IvannnHuang/TableRobot/cad/RobotWheel.stl

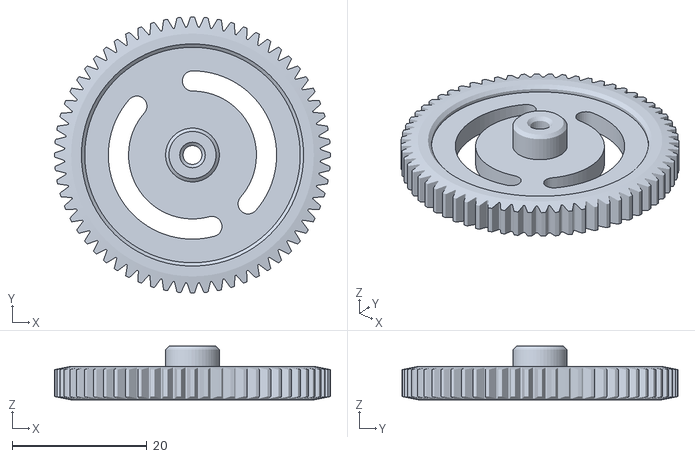
[picture p1: CAD file, 2026-10-29]
cad/RobotWheel.stl
41.0 x 41.0 x 8.00
