IvannnHuang/TableRobot/cad/RobotTOP.stl

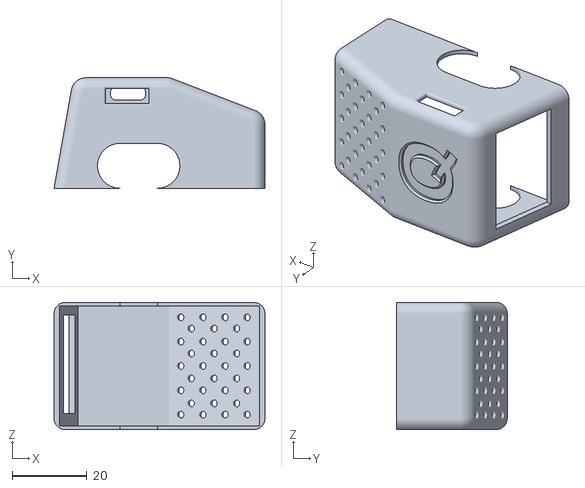
[picture p2: CAD file, 2026-10-27]
cad/RobotTOP.stl
56.4 x 29.5 x 34.0
