IvannnHuang/TableRobot/cad/RobotWheelConnector.stl

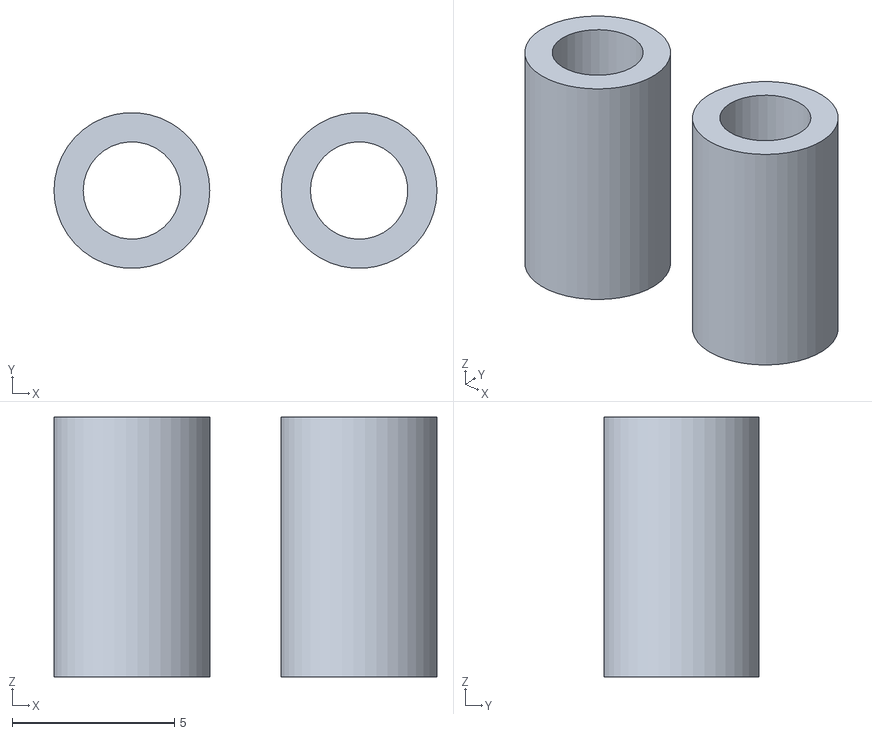
[picture p3: CAD file, 2026-10-27]
cad/RobotWheelConnector.stl
11.8 x 4.79 x 8.00
