IvannnHuang/TableRobot/cad/RobotBOTTOM.stl

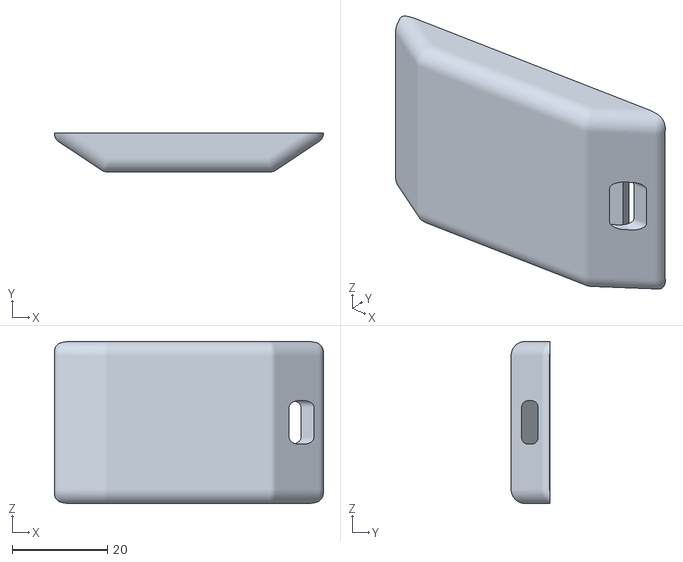
[picture p4: CAD file, 2026-10-27]
cad/RobotBOTTOM.stl
56.4 x 8.13 x 34.0
