IvannnHuang/TableRobot/(list of files, cad)

Other CAD files:
cad/RobotWheel.gcode.3mf
cad/qh229_RobotWheelConnector.gcode.3mf
