IvannnHuang/TableRobot/(commit log)

2026-10-27 tableRobot milestone
    [RobotBOTTOM.stl, RobotTOP.stl, RobotWheelConnector.stl, qh229_RobotWheelConnector.gcode.3mf]
2026-10-28 esp32c3 robot in progress
    [RobotWheel.stl]
2026-10-29 first robot complete
    [RobotWheel.gcode.3mf, RobotWheel.stl]
2026-10-30 Document Microduck walking-robot evaluation
    Add section 9 to ROBOT_PLAN.md (ESP32-S3 feasibility, risks, servo
    options and prices, suggested architecture, pending decisions) and a
    pointer in CLAUDE.md. The Microduck-build-tutorial clone stays untracked.
